Sirawit7205/breadboard-supply/breadboard_supply.kicad_pcb

## KiCad design breadboard_supply.kicad_pcb (2023-06-11)

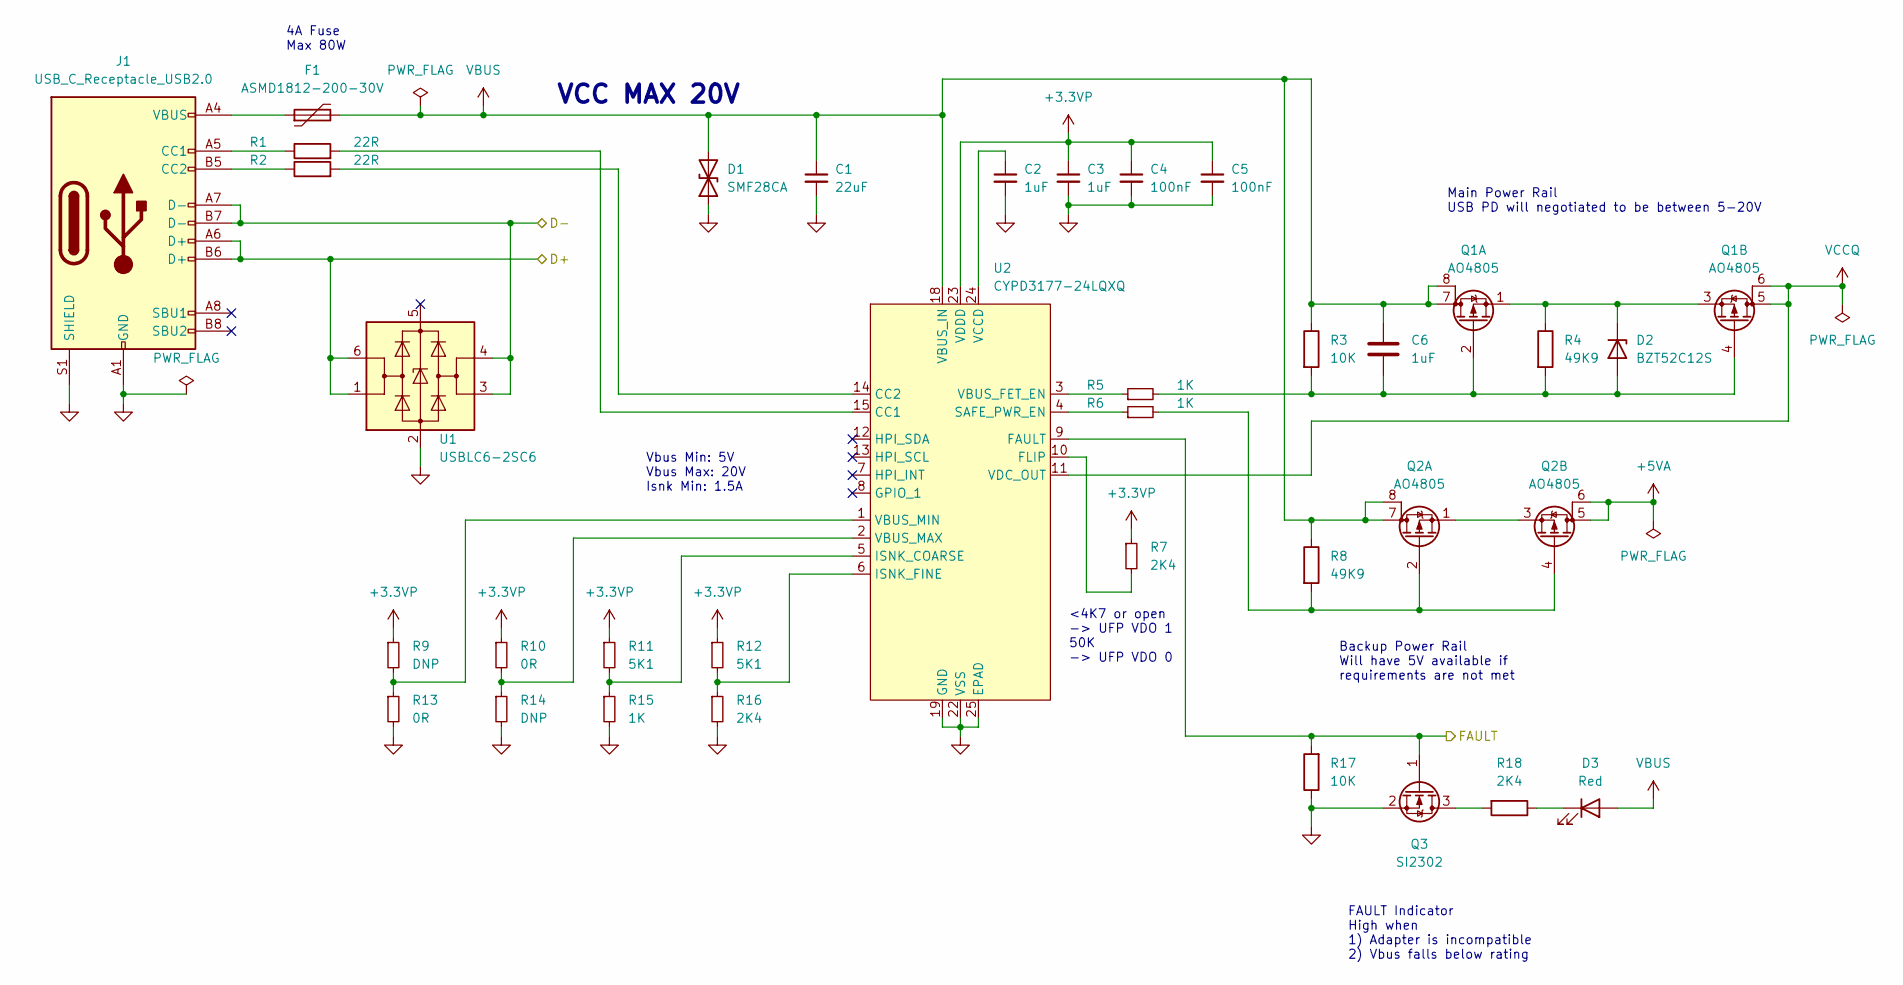
[picture p1: schematic usb.kicad_sch, Dual Rail Breadboard Power Supply]

Parts:
C1: 22uF; C_1210_3225Metric; MPN 22uF 25V X7R
C2, C3, C6: 1uF; C_0603_1608Metric; MPN 1uF 50V X7R
C4, C5: 100nF; C_0603_1608Metric; MPN 100nF 50V X7R
D1: SMF28CA; D_SOD-123; MPN SMF28CA
D2: BZT52C12S; D_SOD-323; MPN BZT52C12S
D3: Red; LED_0603_1608Metric; MPN KT-0603R
F1: ASMD1812-200-30V; Fuse_1812_4532Metric; MPN ASMD1812-200-30V
J1: USB_C_Receptacle_USB2.0; USB_C_Receptacle_HRO_TYPE-C-31-M-12_NO_SBU_CircularHoles; MPN HC-TYPE-C-16P-01A
Q1, Q2: AO4805; SOIC-8_3.9x4.9mm_P1.27mm; MPN AO4805
Q3: SI2302; SOT-23
R1, R2: 22R; R_0603_1608Metric; MPN 22R 1%
R3, R17: 10K; R_0603_1608Metric; MPN 10K 1%
R4, R8: 49K9; R_0603_1608Metric; MPN 49K9 1%
R5, R6, R15: 1K; R_0603_1608Metric; MPN 1K 1%
R7: 2K4; R_0603_1608Metric; MPN 3K3 1%
R9, R14: DNP; R_0603_1608Metric
R10, R13: 0R; R_0603_1608Metric; MPN 0R 1%
R11, R12: 5K1; R_0603_1608Metric; MPN 5K1 1%
R16, R18: 2K4; R_0603_1608Metric; MPN 2K4 1%
U1: USBLC6-2SC6; SOT-23-6; MPN USBLC6-2SC6
U2: CYPD3177-24LQXQ; QFN-24-1EP_4x4mm_P0.5mm_EP2.7x2.7mm; MPN CYPD3177-24LQXQ

Connections:
+3.3VP: C3.1, C4.1, C5.1, R7.1, R9.1, R10.1, R11.1, R12.1, U2.23 (VDDD)
+5VA: Q2.5 (D), Q2.6 (G); also elsewhere on the board
/Microcontroller/D+: J1.A6 (D+), J1.B6 (D+), U1.1 (I/O1), U1.6 (I/O1); also elsewhere on the board
/Microcontroller/D-: J1.A7 (D-), J1.B7 (D-), U1.3 (I/O2), U1.4 (I/O2); also elsewhere on the board
/Microcontroller/PD_FAULT: Q3.1 (G), R17.2, U2.9 (FAULT); also elsewhere on the board
GND: C1.2, C2.2, C3.2, C4.2, C5.2, D1.1 (A1), J1.A1 (GND), J1.A12 (GND), J1.B1 (GND), J1.B12 (GND), J1.S1 (SHIELD), Q3.2 (S), R13.2, R14.2, R15.2, R16.2, R17.1, U1.2 (GND), U2.19 (GND), U2.22 (VSS), U2.25 (EPAD); also elsewhere on the board
unnamed: C2.1, U2.24 (VCCD)
unnamed: C6.2, D2.2 (A), Q1.2 (G), Q1.4 (G), R3.2, R4.2, R5.2
unnamed: D2.1 (K), Q1.1 (S), Q1.3 (S), R4.1
unnamed: D3.1 (K), R18.1
unnamed: F1.1, J1.A4 (VBUS), J1.A9 (VBUS), J1.B4 (VBUS), J1.B9 (VBUS)
unnamed: J1.A5 (CC1), R1.1
unnamed: J1.B5 (CC2), R2.1
unnamed: Q2.1 (S), Q2.3 (S)
unnamed: Q2.2 (G), Q2.4 (G), R6.2, R8.2
unnamed: Q3.3 (D), R18.2
unnamed: R1.2, U2.15 (CC1)
unnamed: R2.2, U2.14 (CC2)
unnamed: R5.1, U2.3 (VBUS_FET_EN)
unnamed: R6.1, U2.4 (SAFE_PWR_EN)
unnamed: R7.2, U2.10 (FLIP)
unnamed: R10.2, R14.1, U2.2 (VBUS_MAX)
unnamed: R11.2, R15.1, U2.5 (ISNK_COARSE)
unnamed: R12.2, R16.1, U2.6 (ISNK_FINE)
unnamed: R9.2, R13.1, U2.1 (VBUS_MIN)
VBUS: C1.1, C6.1, D1.2 (A2), D3.2 (A), F1.2, Q1.7 (D), Q1.8 (G), Q2.7 (D), Q2.8 (G), R3.1, R8.1, U2.18 (VBUS_IN)
VCCQ: Q1.5 (D), Q1.6 (G), U2.11 (VDC_OUT); also elsewhere on the board

Notes on the sheet:
Vbus Min: 5V Vbus Max: 20V Isnk Min: 1.5A
4A Fuse Max 80W
Main Power Rail USB PD will negotiated to be between 5-20V
VCC MAX 20V
<4K7 or open -> UFP VDO 1 50K -> UFP VDO 0
FAULT Indicator High when 1) Adapter is incompatible 2) Vbus falls below rating
Backup Power Rail Will have 5V available if requirements are not met

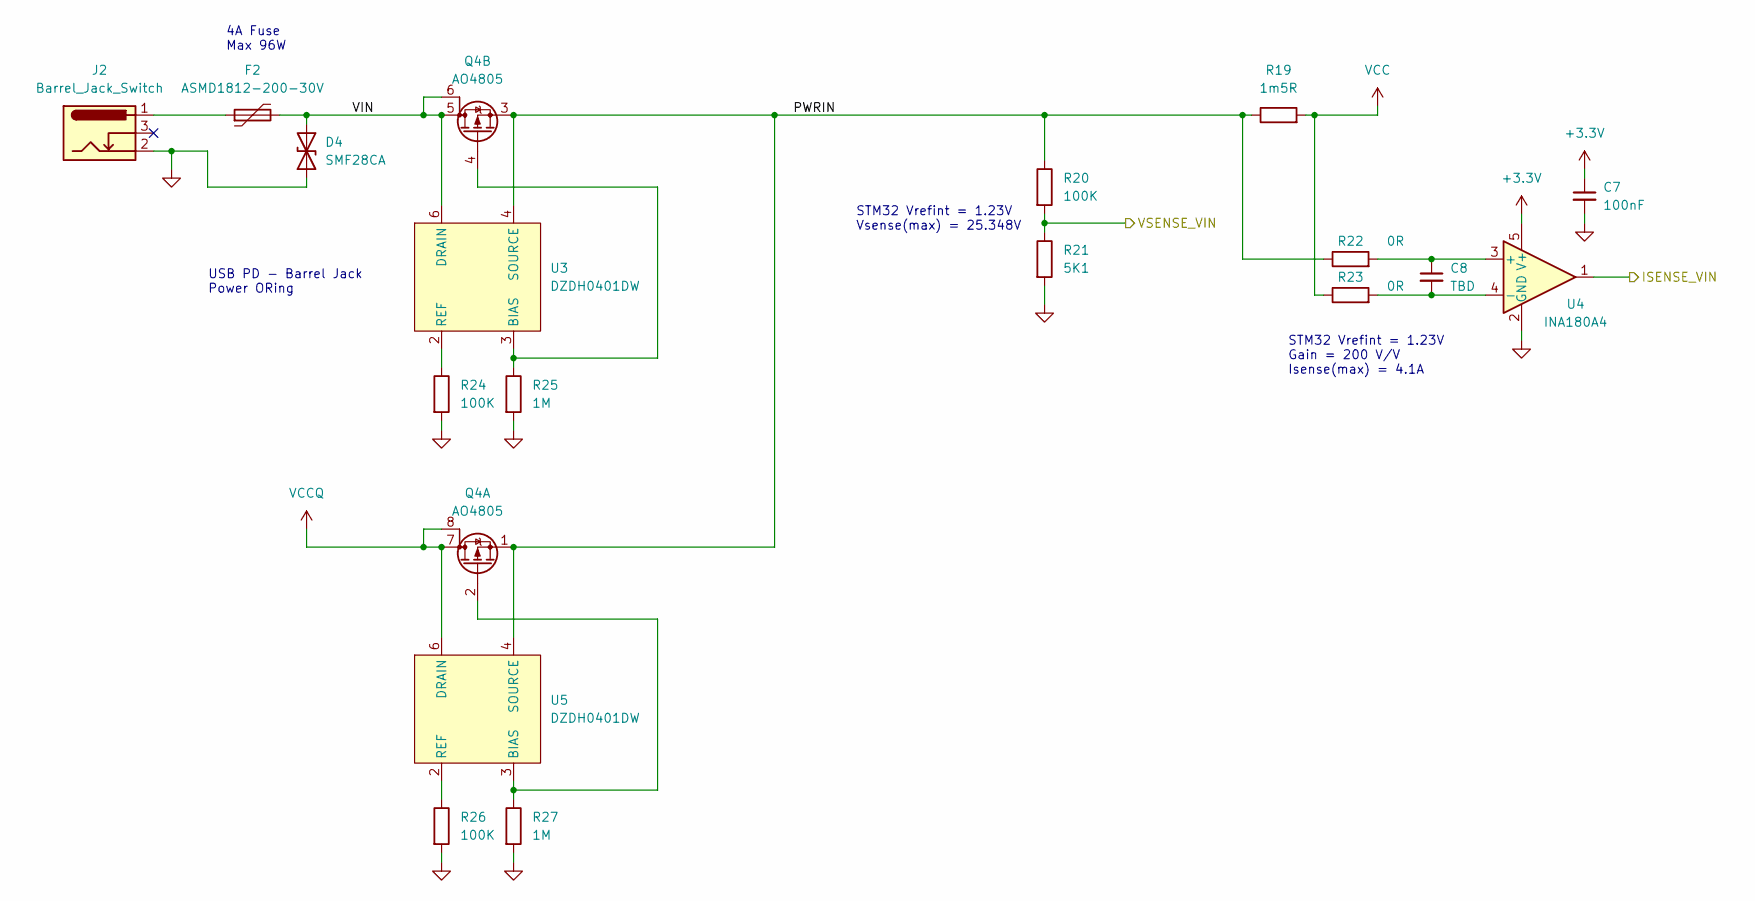
[picture p2: schematic power_input.kicad_sch, Dual Rail Breadboard Power Supply]

Parts:
C7: 100nF; C_0603_1608Metric; MPN 100nF 50V X7R
C8: TBD; C_0603_1608Metric
D4: SMF28CA; D_SOD-123; MPN SMF28CA
F2: ASMD1812-200-30V; Fuse_1812_4532Metric; MPN ASMD1812-200-30V
J2: Barrel_Jack_Switch; BarrelJack_Horizontal; MPN DC-005-5A-2.0
Q4: AO4805; SOIC-8_3.9x4.9mm_P1.27mm; MPN AO4805
R19: 1m5R; R_2512_6332Metric; MPN 1m5R 1%
R20, R24, R26: 100K; R_0603_1608Metric; MPN 100K 1%
R21: 5K1; R_0603_1608Metric; MPN 5K1 1%
R22, R23: 0R; R_0603_1608Metric; MPN 0R 1%
R25, R27: 1M; R_0603_1608Metric; MPN 1M 1%
U3, U5: DZDH0401DW; SOT-363_SC-70-6; MPN DZDH0401DW-7
U4: INA180A4; SOT-23-5; MPN INA180A4IDBVR

Connections:
+3.3V: C7.1, U4.5 (V+); also elsewhere on the board
/Microcontroller/ISENSE_VIN: U4.1; also elsewhere on the board
/Microcontroller/VSENSE_VIN: R20.2, R21.1; also elsewhere on the board
/Power Input/PWRIN: Q4.1 (S), Q4.3 (S), R19.1, R20.1, R22.1, U3.4 (SOURCE), U5.4 (SOURCE)
/Power Input/VIN: D4.2 (A2), F2.2, Q4.5 (D), Q4.6 (G), U3.6 (DRAIN)
GND: C7.2, D4.1 (A1), J2.2, R21.2, R24.2, R25.2, R26.2, R27.2, U4.2 (GND); also elsewhere on the board
unnamed: C8.1, R22.2, U4.3 (+)
unnamed: C8.2, R23.2, U4.4 (-)
unnamed: F2.1, J2.1
unnamed: Q4.2 (G), R27.1, U5.3 (BIAS)
unnamed: Q4.4 (G), R25.1, U3.3 (BIAS)
unnamed: R24.1, U3.2 (REF)
unnamed: R26.1, U5.2 (REF)
VCC: R19.2, R23.1; also elsewhere on the board
VCCQ: Q4.7 (D), Q4.8 (G), U5.6 (DRAIN); also elsewhere on the board

Notes on the sheet:
4A Fuse Max 96W
STM32 Vrefint = 1.23V Vsense(max) = 25.348V
STM32 Vrefint = 1.23V Gain = 200 V/V Isense(max) = 4.1A
USB PD - Barrel Jack Power ORing

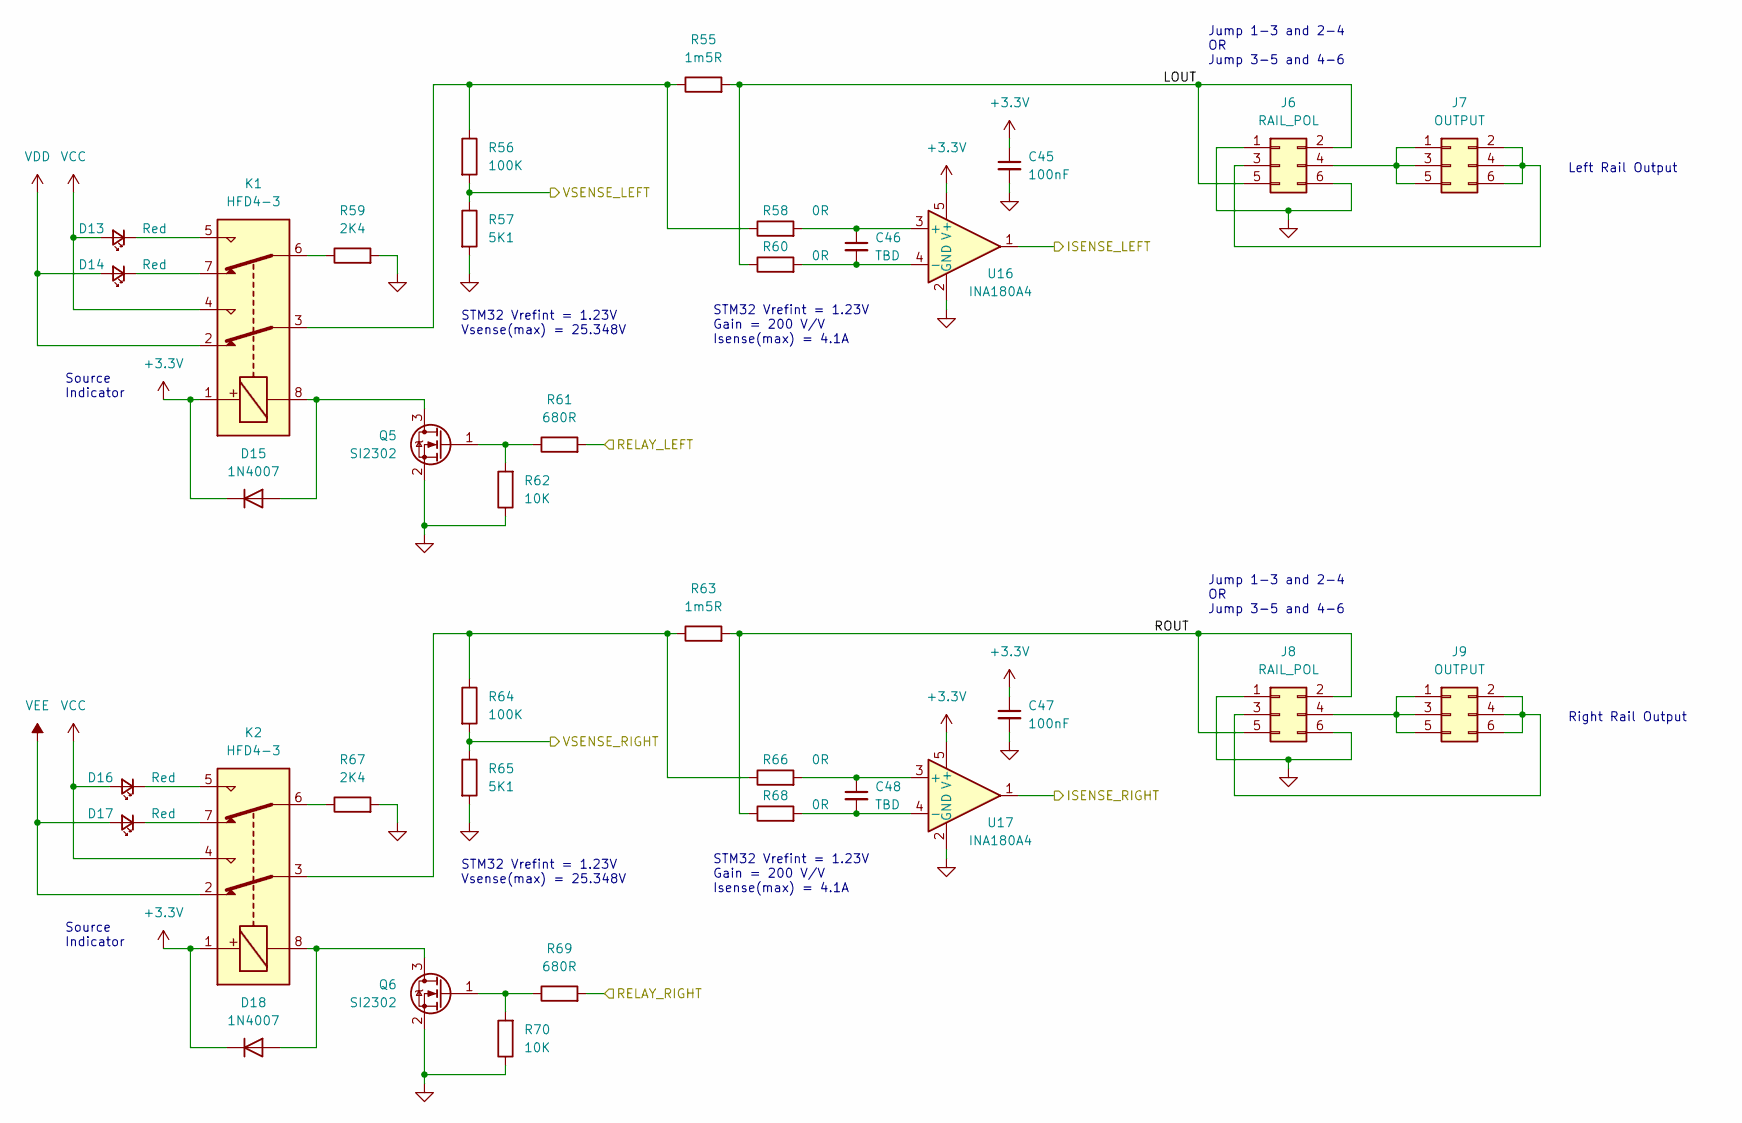
[picture p3: schematic output_stage.kicad_sch, Dual Rail Breadboard Power Supply]

Parts:
C45, C47: 100nF; C_0603_1608Metric; MPN 100nF 50V X7R
C46, C48: TBD; C_0603_1608Metric
D13, D14, D16, D17: Red; LED_0603_1608Metric; MPN KT-0603R
D15, D18: 1N4007; D_SOD-123; MPN A7
J6, J8: RAIL_POL; PinHeader_2x03_P2.54mm_Vertical
J7, J9: OUTPUT; PinHeader_2x03_P2.54mm_Vertical
K1, K2: HFD4-3; HFD4; MPN HFD4/3-SR
Q5, Q6: SI2302; SOT-23; MPN SI2302
R55, R63: 1m5R; R_2512_6332Metric; MPN 1m5R 1%
R56, R64: 100K; R_0603_1608Metric; MPN 100K 1%
R57, R65: 5K1; R_0603_1608Metric; MPN 5K1 1%
R58, R60, R66, R68: 0R; R_0603_1608Metric; MPN 0R 1%
R59, R67: 2K4; R_0603_1608Metric; MPN 2K4 1%
R61, R69: 680R; R_0603_1608Metric; MPN 680R 1%
R62, R70: 10K; R_0603_1608Metric; MPN 10K 1%
U16, U17: INA180A4; SOT-23-5; MPN INA180A4IDBVR

Connections:
+3.3V: C45.1, C47.1, D15.1 (K), D18.1 (K), K1.1, K2.1, U16.5 (V+), U17.5 (V+); also elsewhere on the board
/Microcontroller/ISENSE_LEFT: U16.1; also elsewhere on the board
/Microcontroller/ISENSE_RIGHT: U17.1; also elsewhere on the board
/Microcontroller/RELAY_LEFT: R61.2; also elsewhere on the board
/Microcontroller/RELAY_RIGHT: R69.2; also elsewhere on the board
/Microcontroller/VSENSE_LEFT: R56.2, R57.1; also elsewhere on the board
/Microcontroller/VSENSE_RIGHT: R64.2, R65.1; also elsewhere on the board
/Output Stage/LOUT: J6.2, J6.5, R55.2, R60.1
/Output Stage/ROUT: J8.2, J8.5, R63.2, R68.1
GND: C45.2, C47.2, J6.1, J6.6, J8.1, J8.6, Q5.2 (S), Q6.2 (S), R57.2, R59.2, R62.1, R65.2, R67.2, R70.1, U16.2 (GND), U17.2 (GND); also elsewhere on the board
unnamed: C46.1, R58.2, U16.3 (+)
unnamed: C46.2, R60.2, U16.4 (-)
unnamed: C48.1, R66.2, U17.3 (+)
unnamed: C48.2, R68.2, U17.4 (-)
unnamed: D13.1 (K), K1.5
unnamed: D14.1 (K), K1.7
unnamed: D15.2 (A), K1.8, Q5.3 (D)
unnamed: D16.1 (K), K2.5
unnamed: D17.1 (K), K2.7
unnamed: D18.2 (A), K2.8, Q6.3 (D)
unnamed: J6.3, J7.2, J7.4, J7.6
unnamed: J6.4, J7.1, J7.3, J7.5
unnamed: J8.3, J9.2, J9.4, J9.6
unnamed: J8.4, J9.1, J9.3, J9.5
unnamed: K1.3, R55.1, R56.1, R58.1
unnamed: K1.6, R59.1
unnamed: K2.3, R63.1, R64.1, R66.1
unnamed: K2.6, R67.1
unnamed: Q5.1 (G), R61.1, R62.2
unnamed: Q6.1 (G), R69.1, R70.2
VCC: D13.2 (A), D16.2 (A), K1.4, K2.4; also elsewhere on the board
VDD: D14.2 (A), K1.2; also elsewhere on the board
VEE: D17.2 (A), K2.2; also elsewhere on the board

Notes on the sheet:
STM32 Vrefint = 1.23V Vsense(max) = 25.348V
Left Rail Output
Source Indicator
Right Rail Output
Jump 1-3 and 2-4 OR Jump 3-5 and 4-6
STM32 Vrefint = 1.23V Gain = 200 V/V Isense(max) = 4.1A

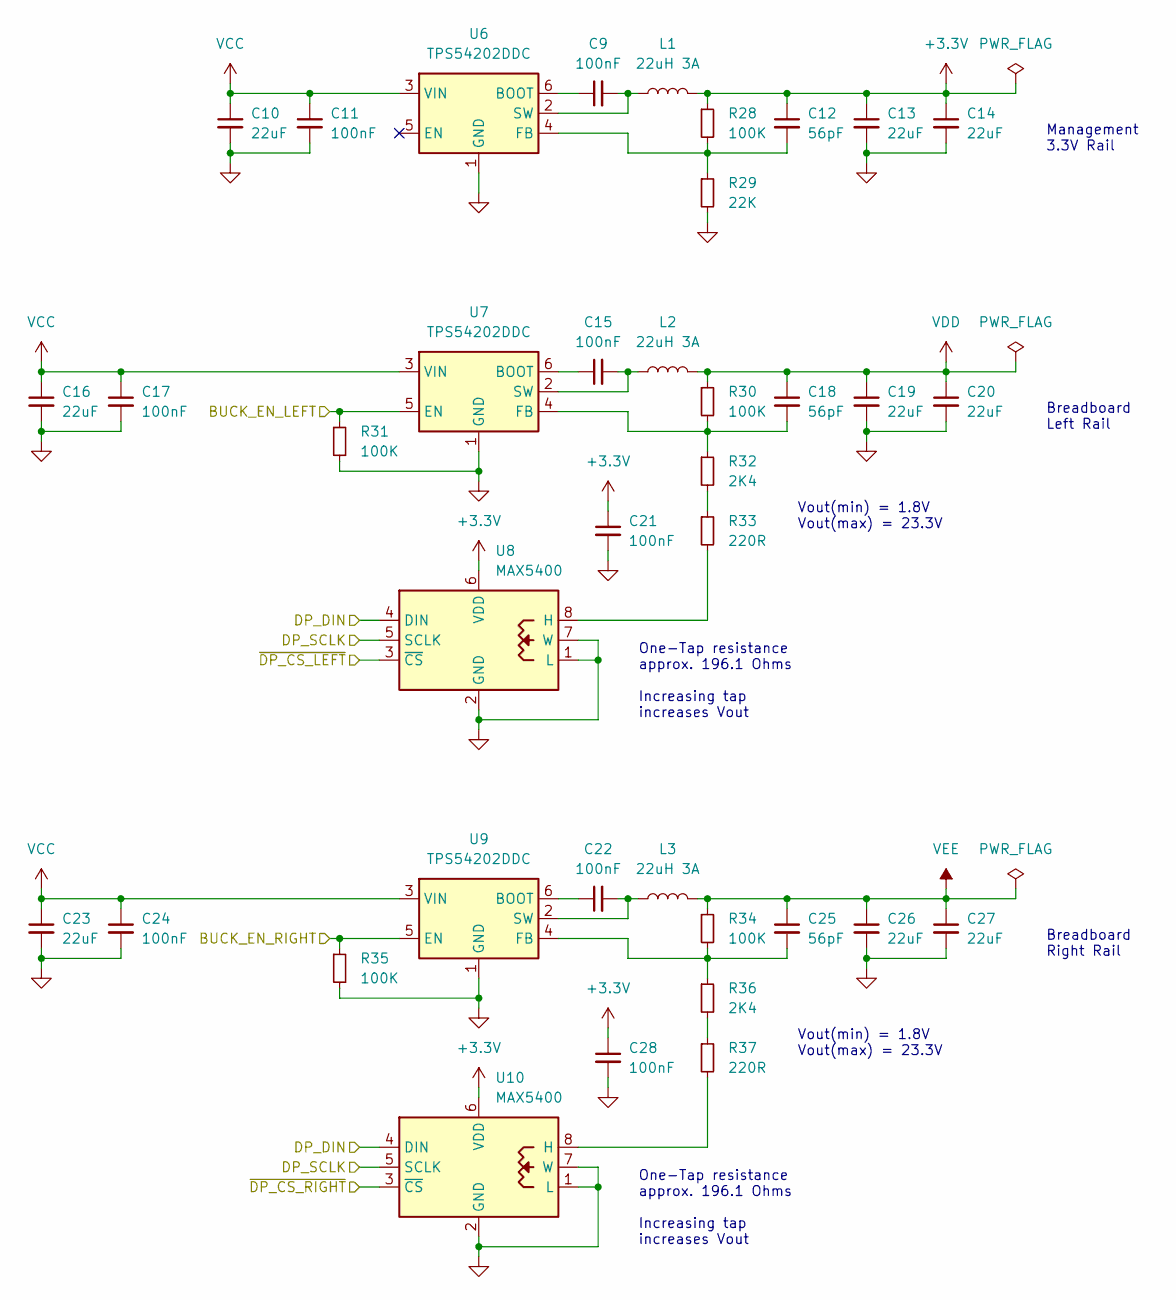
[picture p4: schematic buck_converter.kicad_sch, Dual Rail Breadboard Power Supply]

Parts:
C9, C11, C15, C17, C21, C22, C24, C28: 100nF; C_0603_1608Metric; MPN 100nF 50V X7R
C10, C13, C14, C16, C19, C20, C23, C26, C27: 22uF; C_1210_3225Metric; MPN 22uF 25V X7R
C12, C18, C25: 56pF; C_0603_1608Metric; MPN 56pF 50V C0G
L1, L2, L3: 22uH 3A; L_Bourns_SRN6045TA; MPN SRN6045TA-220M
R28, R30, R31, R34, R35: 100K; R_0603_1608Metric; MPN 100K 1%
R29: 22K; R_0603_1608Metric; MPN 22K 1%
R32, R36: 2K4; R_0603_1608Metric; MPN 2K4 1%
R33, R37: 220R; R_0603_1608Metric; MPN 220R 1%
U6, U7, U9: TPS54202DDC; SOT-23-6; MPN TPS54202DDCR
U8, U10: MAX5400; SOT-23-8; MPN MAX5400EKA+T

Connections:
+3.3V: C12.1, C13.1, C14.1, C21.1, C28.1, L1.2, R28.1, U8.6 (VDD), U10.6 (VDD); also elsewhere on the board
/Buck Converter/BUCK_EN_LEFT: R31.1, U7.5 (EN); also elsewhere on the board
/Buck Converter/BUCK_EN_RIGHT: R35.1, U9.5 (EN); also elsewhere on the board
/Buck Converter/DP_DIN: U8.4 (DIN), U10.4 (DIN); also elsewhere on the board
/Buck Converter/DP_SCLK: U8.5 (SCLK), U10.5 (SCLK); also elsewhere on the board
/Buck Converter/~DP_CS_LEFT: U8.3 (~CS); also elsewhere on the board
/Buck Converter/~DP_CS_RIGHT: U10.3 (~CS); also elsewhere on the board
GND: C10.2, C11.2, C13.2, C14.2, C16.2, C17.2, C19.2, C20.2, C21.2, C23.2, C24.2, C26.2, C27.2, C28.2, R29.2, R31.2, R35.2, U6.1 (GND), U7.1 (GND), U8.1 (L), U8.2 (GND), U8.7 (W), U9.1 (GND), U10.1 (L), U10.2 (GND), U10.7 (W); also elsewhere on the board
unnamed: C9.1, U6.6 (BOOT)
unnamed: C9.2, L1.1, U6.2 (SW)
unnamed: C12.2, R28.2, R29.1, U6.4 (FB)
unnamed: C15.1, U7.6 (BOOT)
unnamed: C15.2, L2.1, U7.2 (SW)
unnamed: C18.2, R30.2, R32.1, U7.4 (FB)
unnamed: C22.1, U9.6 (BOOT)
unnamed: C22.2, L3.1, U9.2 (SW)
unnamed: C25.2, R34.2, R36.1, U9.4 (FB)
unnamed: R32.2, R33.1
unnamed: R33.2, U8.8 (H)
unnamed: R36.2, R37.1
unnamed: R37.2, U10.8 (H)
VCC: C10.1, C11.1, C16.1, C17.1, C23.1, C24.1, U6.3 (VIN), U7.3 (VIN), U9.3 (VIN); also elsewhere on the board
VDD: C18.1, C19.1, C20.1, L2.2, R30.1; also elsewhere on the board
VEE: C25.1, C26.1, C27.1, L3.2, R34.1; also elsewhere on the board

Notes on the sheet:
Vout(min) = 1.8V Vout(max) = 23.3V
Breadboard Right Rail
One-Tap resistance approx. 196.1 Ohms Increasing tap increases Vout
Breadboard Left Rail
Management 3.3V Rail

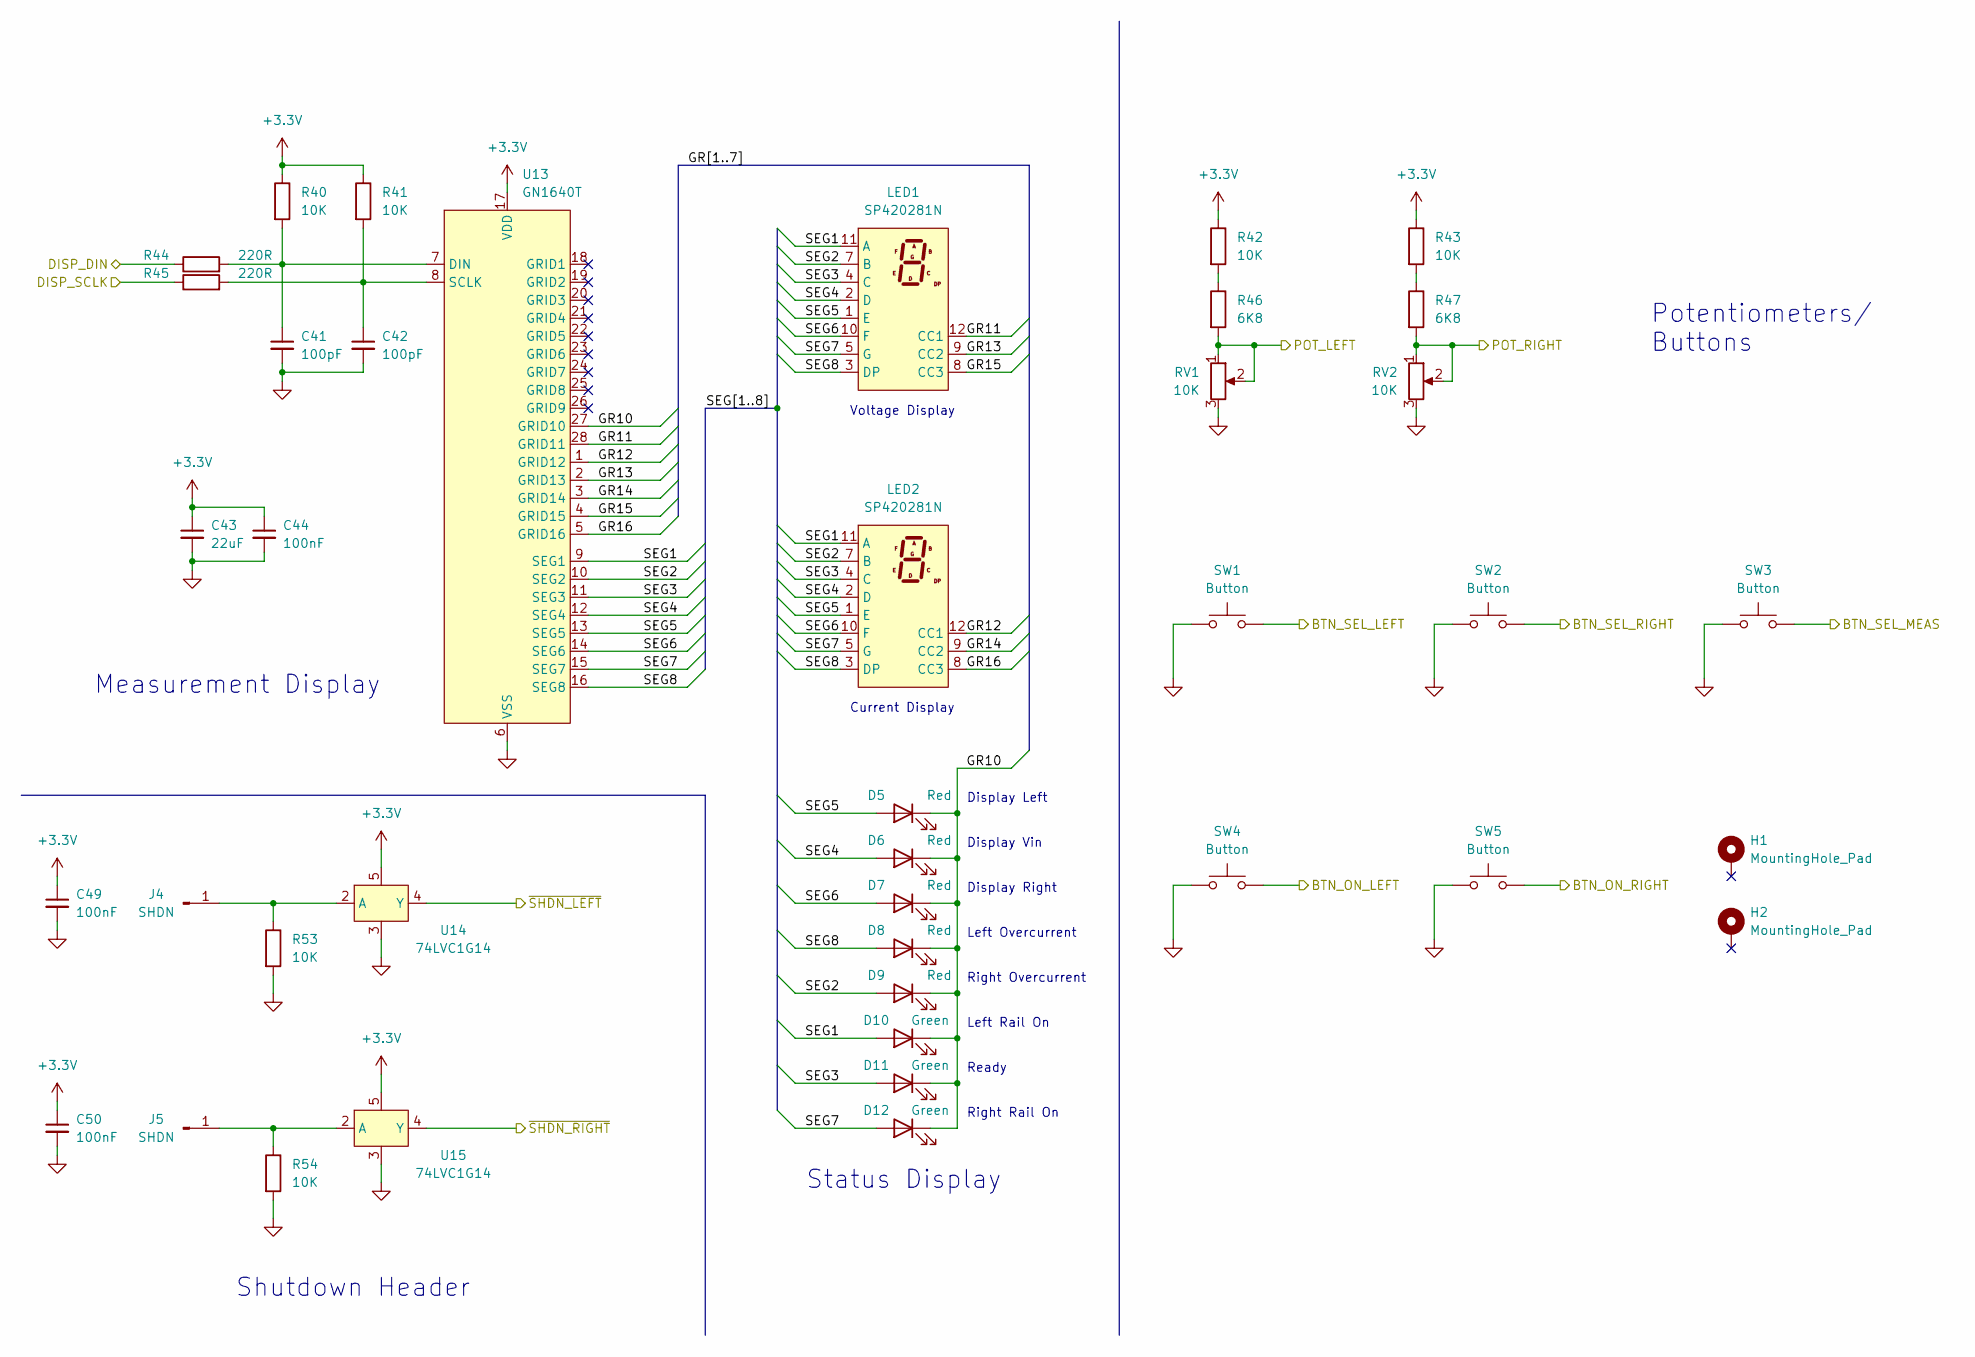
[picture p5: schematic user_interface.kicad_sch, Dual Rail Breadboard Power Supply]

Parts:
C41, C42: 100pF; C_0603_1608Metric; MPN 100pF 50V C0G
C43: 22uF; C_1210_3225Metric; MPN 22uF 25V X7R
C44, C49, C50: 100nF; C_0603_1608Metric; MPN 100nF 50V X7R
D5, D6, D7, D8, D9: Red; LED_0603_1608Metric; MPN KT-0603R
D10, D11, D12: Green; LED_0603_1608Metric; MPN 19-217/GHC-YR1S2/3T
H1, H2: MountingHole_Pad; MountingHole_3.2mm_M3_Pad
J4, J5: SHDN; PinHeader_1x01_P2.54mm_Vertical
LED1, LED2: SP420281N; MPN SP420281N
R40, R41, R42, R43, R53, R54: 10K; R_0603_1608Metric; MPN 10K 1%
R44, R45: 220R; R_0603_1608Metric; MPN 220R 1%
R46, R47: 6K8; R_0603_1608Metric; MPN 6K8 1%
RV1, RV2: 10K; Potentiometer_Bourns_3386P_Vertical; MPN 3386P-1-103TLF
SW1, SW2, SW3, SW4, SW5: Button; SW_SPST_CK_RS282G05A3; MPN TS-1101-C-W
U13: GN1640T; SSOP-28_3.9x9.9mm_P0.635mm; MPN GN1640T
U14, U15: 74LVC1G14; SOT-353_SC-70-5; MPN 74LVC1G14GW,125

Connections:
+3.3V: C43.1, C44.1, C49.1, C50.1, R40.1, R41.1, R42.1, R43.1, U13.17 (VDD), U14.5, U15.5; also elsewhere on the board
/Microcontroller/BTN_ON_LEFT: SW4.2; also elsewhere on the board
/Microcontroller/BTN_ON_RIGHT: SW5.2; also elsewhere on the board
/Microcontroller/BTN_SEL_LEFT: SW1.2; also elsewhere on the board
/Microcontroller/BTN_SEL_MEAS: SW3.2; also elsewhere on the board
/Microcontroller/BTN_SEL_RIGHT: SW2.2; also elsewhere on the board
/Microcontroller/POT_LEFT: R46.2, RV1.1, RV1.2; also elsewhere on the board
/Microcontroller/POT_RIGHT: R47.2, RV2.1, RV2.2; also elsewhere on the board
/Microcontroller/SPI2_MOSI: R44.1; also elsewhere on the board
/Microcontroller/SPI2_SCK: R45.1; also elsewhere on the board
/Microcontroller/~SHDN_LEFT: U14.4 (Y); also elsewhere on the board
/Microcontroller/~SHDN_RIGHT: U15.4 (Y); also elsewhere on the board
/User Interface/GR10: D5.1 (K), D6.1 (K), D7.1 (K), D8.1 (K), D9.1 (K), D10.1 (K), D11.1 (K), D12.1 (K), U13.27 (GRID10)
/User Interface/GR11: LED1.12 (CC1), U13.28 (GRID11)
/User Interface/GR12: LED2.12 (CC1), U13.1 (GRID12)
/User Interface/GR13: LED1.9 (CC2), U13.2 (GRID13)
/User Interface/GR14: LED2.9 (CC2), U13.3 (GRID14)
/User Interface/GR15: LED1.8 (CC3), U13.4 (GRID15)
/User Interface/GR16: LED2.8 (CC3), U13.5 (GRID16)
/User Interface/SEG1: D10.2 (A), LED1.11 (A), LED2.11 (A), U13.9 (SEG1)
/User Interface/SEG2: D9.2 (A), LED1.7 (B), LED2.7 (B), U13.10 (SEG2)
/User Interface/SEG3: D11.2 (A), LED1.4 (C), LED2.4 (C), U13.11 (SEG3)
/User Interface/SEG4: D6.2 (A), LED1.2 (D), LED2.2 (D), U13.12 (SEG4)
/User Interface/SEG5: D5.2 (A), LED1.1 (E), LED2.1 (E), U13.13 (SEG5)
/User Interface/SEG6: D7.2 (A), LED1.10 (F), LED2.10 (F), U13.14 (SEG6)
/User Interface/SEG7: D12.2 (A), LED1.5 (G), LED2.5 (G), U13.15 (SEG7)
/User Interface/SEG8: D8.2 (A), LED1.3 (DP), LED2.3 (DP), U13.16 (SEG8)
GND: C41.2, C42.2, C43.2, C44.2, C49.2, C50.2, R53.2, R54.2, RV1.3, RV2.3, SW1.1, SW2.1, SW3.1, SW4.1, SW5.1, U13.6 (VSS), U14.3, U15.3; also elsewhere on the board
unnamed: C41.1, R40.2, R44.2, U13.7 (DIN)
unnamed: C42.1, R41.2, R45.2, U13.8 (SCLK)
unnamed: J4.1, R53.1, U14.2 (A)
unnamed: J5.1, R54.1, U15.2 (A)
unnamed: R42.2, R46.1
unnamed: R43.2, R47.1

Notes on the sheet:
Display Left
Voltage Display
Display Right
Shutdown Header
Left Rail On
Ready
Display Vin
Right Rail On
Right Overcurrent
Current Display
Measurement Display
Potentiometers/ Buttons
Left Overcurrent
Status Display

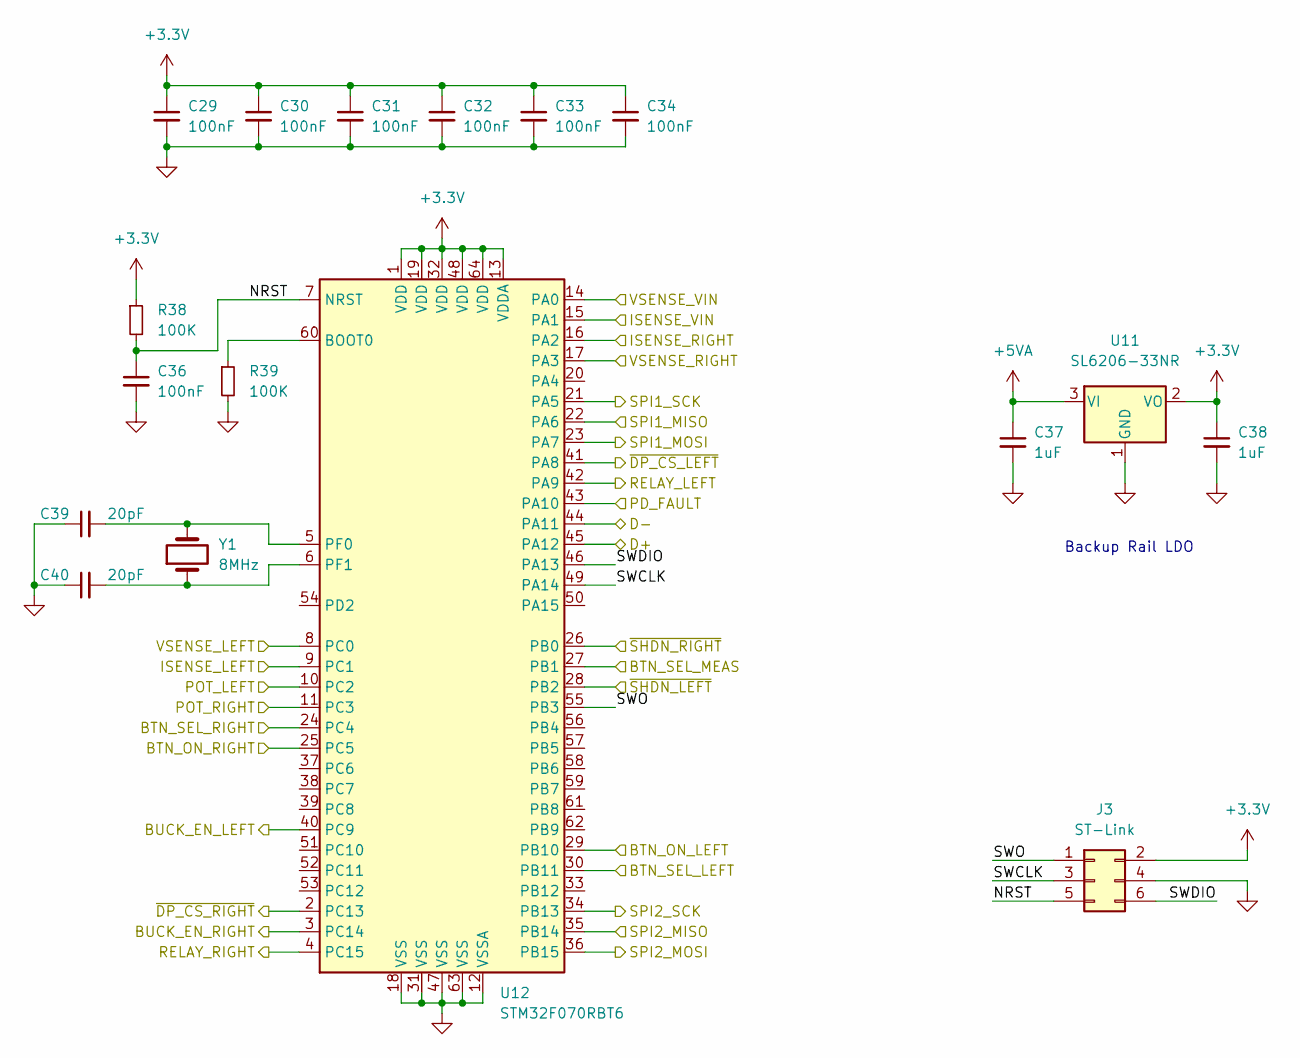
[picture p6: schematic microcontroller.kicad_sch, Dual Rail Breadboard Power Supply]

Parts:
C29, C30, C31, C32, C33, C34, C36: 100nF; C_0603_1608Metric; MPN 100nF 50V X7R
C37, C38: 1uF; C_0603_1608Metric; MPN 1uF 50V X7R
C39, C40: 20pF; C_0603_1608Metric; MPN 20pF 50V C0G
J3: ST-Link; PinHeader_2x03_P1.27mm_Vertical_SMD
R38, R39: 100K; R_0603_1608Metric; MPN 100K 1%
U11: SL6206-33NR; SOT-23; MPN XC6206P332MRN
U12: STM32F070RBT6; LQFP-64_10x10mm_P0.5mm; MPN STM32F070RBT6
Y1: 8MHz; Crystal_SMD_5032-2Pin_5.0x3.2mm; MPN ECS-80-8-30-JGN-TR

Connections:
+3.3V: C29.1, C30.1, C31.1, C32.1, C33.1, C34.1, C38.1, J3.2, R38.1, U11.2 (VO), U12.1 (VDD), U12.13 (VDDA), U12.19 (VDD), U12.32 (VDD), U12.48 (VDD), U12.64 (VDD); also elsewhere on the board
+5VA: C37.1, U11.3 (VI); also elsewhere on the board
/Buck Converter/BUCK_EN_LEFT: U12.40 (PC9); also elsewhere on the board
/Buck Converter/BUCK_EN_RIGHT: U12.3 (PC14); also elsewhere on the board
/Buck Converter/DP_DIN: U12.23 (PA7); also elsewhere on the board
/Buck Converter/DP_SCLK: U12.21 (PA5); also elsewhere on the board
/Buck Converter/~DP_CS_LEFT: U12.41 (PA8); also elsewhere on the board
/Buck Converter/~DP_CS_RIGHT: U12.2 (PC13); also elsewhere on the board
/Microcontroller/BTN_ON_LEFT: U12.29 (PB10); also elsewhere on the board
/Microcontroller/BTN_ON_RIGHT: U12.25 (PC5); also elsewhere on the board
/Microcontroller/BTN_SEL_LEFT: U12.30 (PB11); also elsewhere on the board
/Microcontroller/BTN_SEL_MEAS: U12.27 (PB1); also elsewhere on the board
/Microcontroller/BTN_SEL_RIGHT: U12.24 (PC4); also elsewhere on the board
/Microcontroller/D+: U12.45 (PA12); also elsewhere on the board
/Microcontroller/D-: U12.44 (PA11); also elsewhere on the board
/Microcontroller/ISENSE_LEFT: U12.9 (PC1); also elsewhere on the board
/Microcontroller/ISENSE_RIGHT: U12.16 (PA2); also elsewhere on the board
/Microcontroller/ISENSE_VIN: U12.15 (PA1); also elsewhere on the board
/Microcontroller/NRST: C36.1, J3.5, R38.2, U12.7 (NRST)
/Microcontroller/PD_FAULT: U12.43 (PA10); also elsewhere on the board
/Microcontroller/POT_LEFT: U12.10 (PC2); also elsewhere on the board
/Microcontroller/POT_RIGHT: U12.11 (PC3); also elsewhere on the board
/Microcontroller/RELAY_LEFT: U12.42 (PA9); also elsewhere on the board
/Microcontroller/RELAY_RIGHT: U12.4 (PC15); also elsewhere on the board
/Microcontroller/SPI1_MISO: U12.22 (PA6)
/Microcontroller/SPI2_MISO: U12.35 (PB14)
/Microcontroller/SPI2_MOSI: U12.36 (PB15); also elsewhere on the board
/Microcontroller/SPI2_SCK: U12.34 (PB13); also elsewhere on the board
/Microcontroller/SWCLK: J3.3, U12.49 (PA14)
/Microcontroller/SWDIO: J3.6, U12.46 (PA13)
/Microcontroller/SWO: J3.1, U12.55 (PB3)
/Microcontroller/VSENSE_LEFT: U12.8 (PC0); also elsewhere on the board
/Microcontroller/VSENSE_RIGHT: U12.17 (PA3); also elsewhere on the board
/Microcontroller/VSENSE_VIN: U12.14 (PA0); also elsewhere on the board
/Microcontroller/~SHDN_LEFT: U12.28 (PB2); also elsewhere on the board
/Microcontroller/~SHDN_RIGHT: U12.26 (PB0); also elsewhere on the board
GND: C29.2, C30.2, C31.2, C32.2, C33.2, C34.2, C36.2, C37.2, C38.2, C39.1, C40.1, J3.4, R39.2, U11.1 (GND), U12.12 (VSSA), U12.18 (VSS), U12.31 (VSS), U12.47 (VSS), U12.63 (VSS); also elsewhere on the board
unnamed: C39.2, U12.5 (PF0), Y1.2
unnamed: C40.2, U12.6 (PF1), Y1.1
unnamed: R39.1, U12.60 (BOOT0)

Notes on the sheet:
Backup Rail LDO

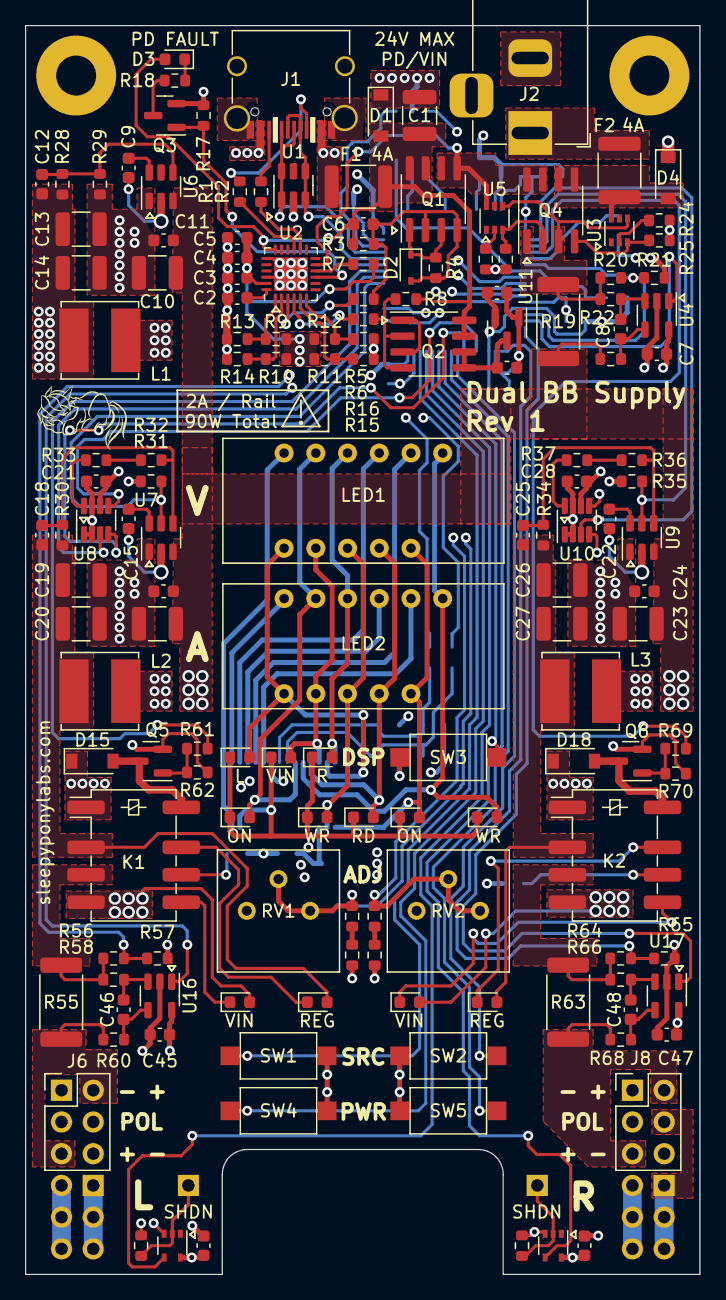
[picture p7: board breadboard_supply.kicad_pcb from above]

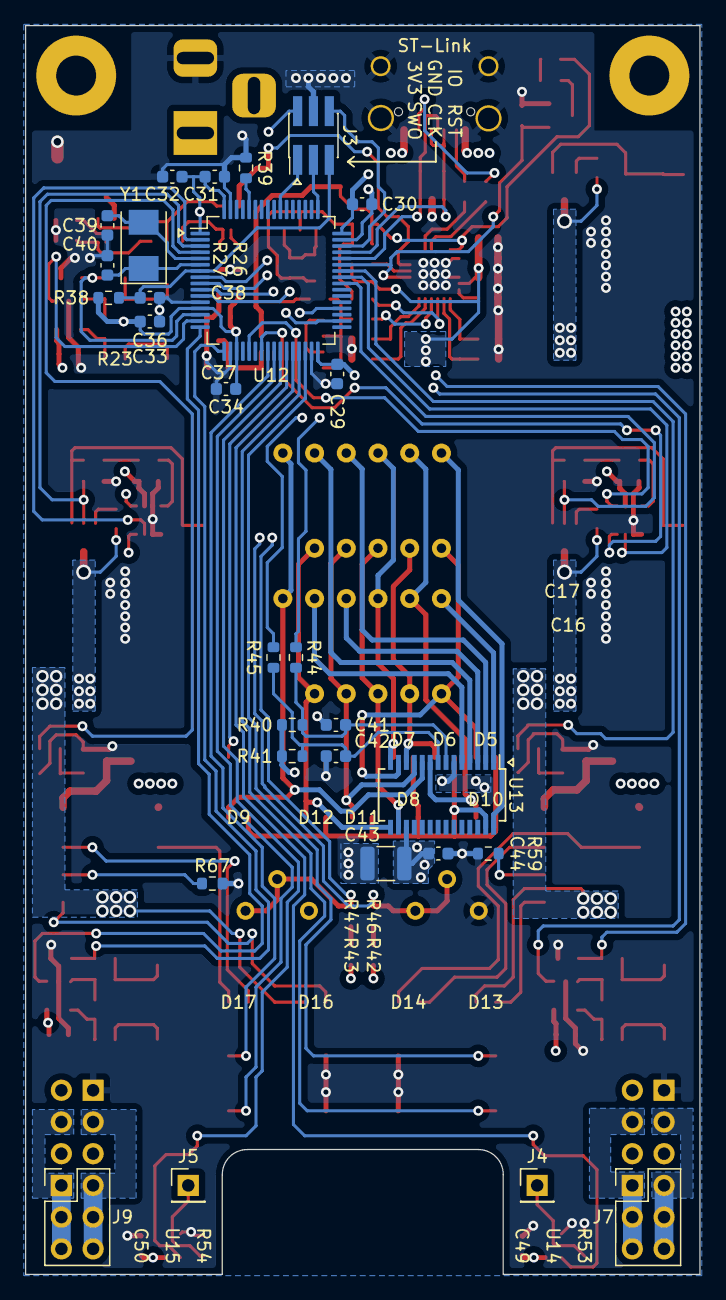
[picture p8: board breadboard_supply.kicad_pcb from below]

Board: 4 copper layers, 54.0 x 100.0 mm, 183 parts (29 on the bottom side), 128 nets.
