Sirawit7205/breadboard-supply/(commit log)

2023-05-28 Initial Commit, PCB WIP
    [breadboard_supply.kicad_pcb, breadboard_supply.kicad_sch, buck_converter.kicad_sch, buck_converter_old.kicad_sch, microcontroller.kicad_sch, output_stage.kicad_sch, power_input.kicad_sch, usb.kicad_sch]
2023-05-30 WIP PCB Routing
    [breadboard_supply.kicad_pcb, breadboard_supply.kicad_sch, buck_converter.kicad_sch]
2023-05-31 Add mounting holes, WIP routing
    [breadboard_supply.kicad_pcb, breadboard_supply.kicad_sch, user_interface.kicad_sch]
2023-06-07 Add information and BOM consolidation for JLCPCB
    [breadboard_supply.kicad_pcb, breadboard_supply.kicad_sch, power_input.kicad_sch, usb.kicad_sch]
2023-06-10 Power optimization, add Aisler Assembly MPN info
    [breadboard_supply.kicad_pcb, breadboard_supply.kicad_sch, buck_converter.kicad_sch, microcontroller.kicad_sch, output_stage.kicad_sch, power_input.kicad_sch, usb.kicad_sch, user_interface.kicad_sch]
2023-06-10 Create IBOM, Add sheet info
    [breadboard_supply.kicad_pcb, breadboard_supply.kicad_sch, buck_converter.kicad_sch, microcontroller.kicad_sch, output_stage.kicad_sch, power_input.kicad_sch, usb.kicad_sch, user_interface.kicad_sch]
2023-06-11 Fixed R7 value
    [breadboard_supply.kicad_pcb, breadboard_supply.kicad_sch, usb.kicad_sch]
